KiwiPlastic/Mjolnir/README.md

# Mjolnir - High Performance Nerf Blaster
**Arduino Nano, ESC bushless motors, OLED, Select Fire**

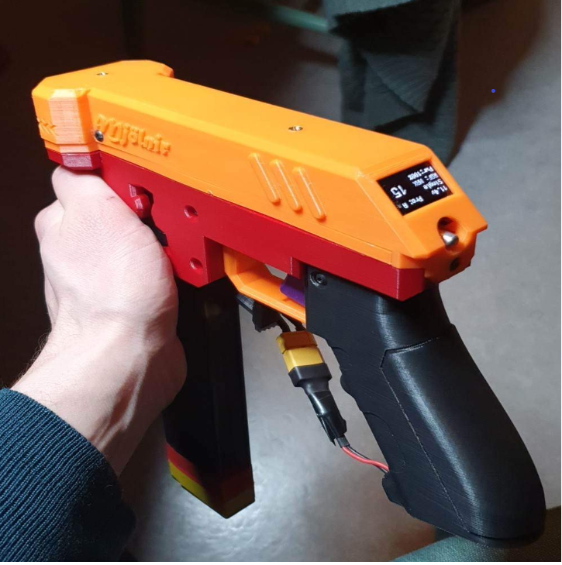
[picture p1: Images/IMG_8636.png]


Hi there and welcome! Thanks alot for checking out Mjölnir - We've been so excited to share this with you, that we simply could'nt wait any longer. This blaster is for the community, by the community. 

This is the finished blaster after about 8 months of work from alot of cool people, but we are hobby-nerf folk, not professionals (Try it out at your own risk).

This is a personal blaster for you and we want you to mod it. There is however a few legal things; The code is a mix of Airzone's free code. This means you are not allowed to sell it. The same goes for the design, which is mainly because we dont want to get kicked off github later on.. 😛 

But you are free to use it as you please to mod etc. You can print all the blasters you want for friends and family for the cost of filament and hugs.

if you have any questions, feel free to reach out to us via discord (https://discord.gg/Edy7qAxdAY) or facebook. 

Kind regards,

Ben, Thor and the rest of the C.R.A.P team

(Cross Rough Atlantic Projects)

## 🚀 Summary

Mjolnir is a Brushless, Solenoid pusher, Micro controlled Blaster with Oled display and Rotary
encoder.

It can be regarded as a medium to advanced electronics project depending on how you approach the
build, however there are no reasons beginners cannot start here -this document is to also help
beginners get involved.

Please see here for detailed Assembly Instructions

Discord Invite

## 🧲 Basic Hardware
    1 x Arduino Nano
    1 x OLED Display
    2 x ESC
    2 x Brushless Motors
    1 x Buck Regulator
    2 x Micro Switch
    1 x Rotary Encoder
    1 x Mosfet
    1 x Solenoid

  **Digram**
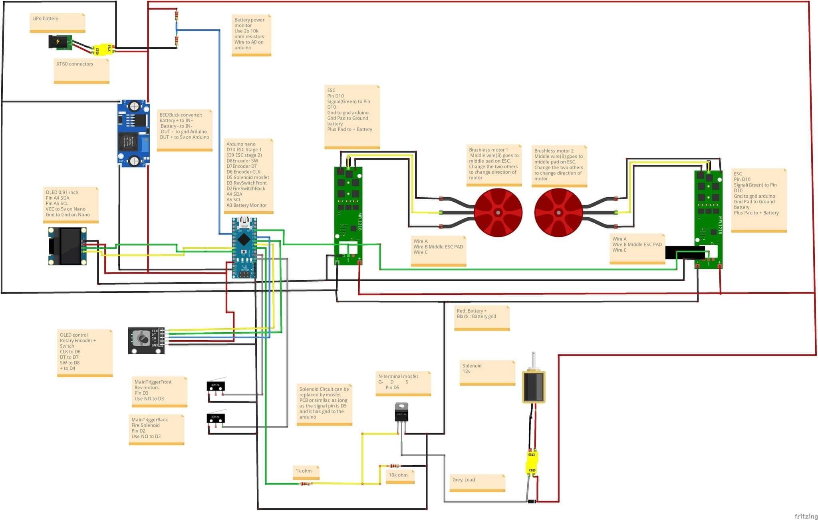
[picture p2: Images/IMG_8562.JPG]


## 🛠️ Usage

Play - Nerf games 
Has 3 firing Modes
 - Singal
 - Burst
 - Auto

Use Encoder and Oled to change setings via menu

## 📜 License
Distributed under the Creative Commons Zero v1.0 Universal License. See `LICENSE` for more information.
