KiwiPlastic/Mjolnir/Images/IMG_8597.PNG

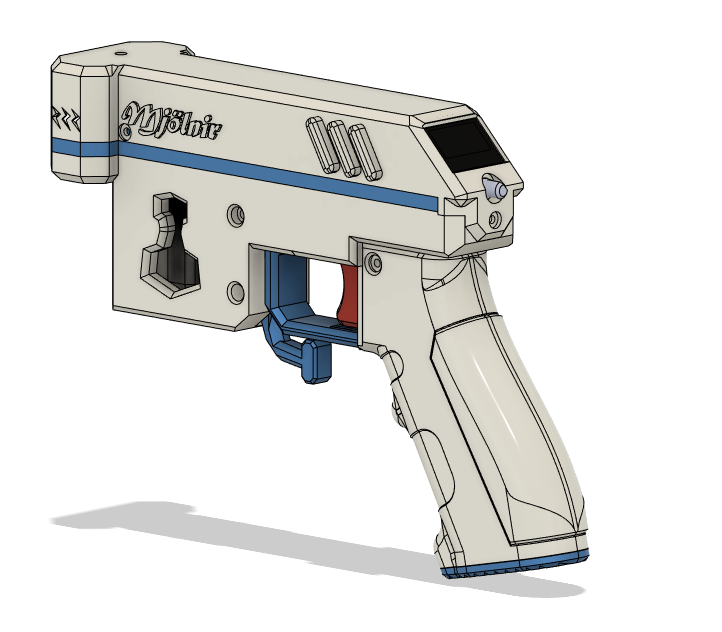
Images/IMG_8597.PNG
