KiwiPlastic/Mjolnir/Images/IMG_8598.PNG

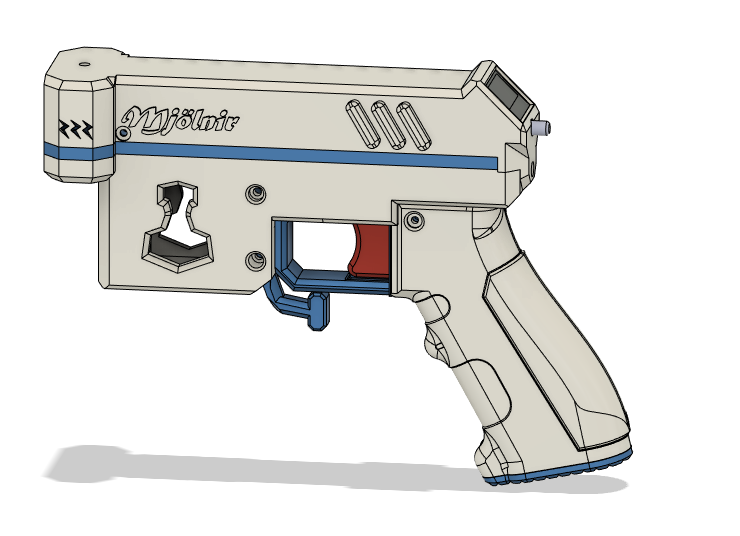
Images/IMG_8598.PNG
