KiwiPlastic/Mjolnir/Images/IMG_8599.PNG

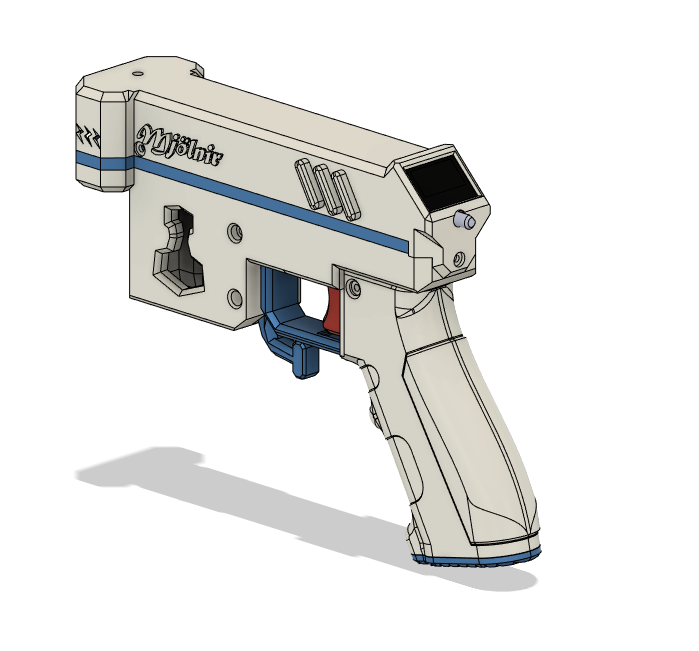
Images/IMG_8599.PNG
