KiwiPlastic/Mjolnir/Images/IMG_8601.PNG

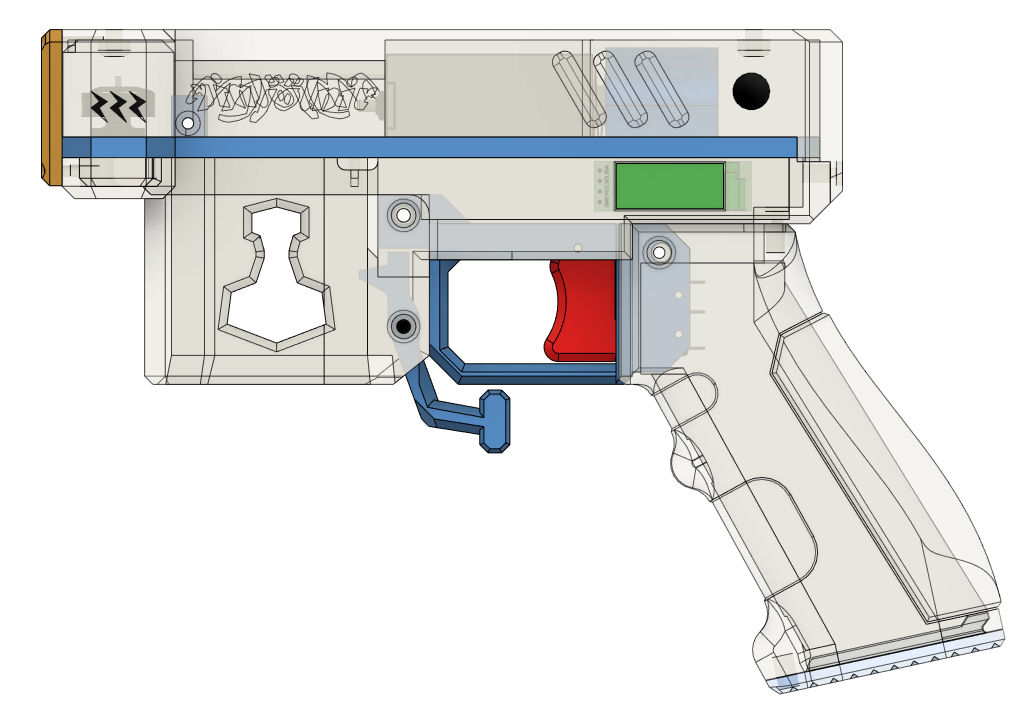
Images/IMG_8601.PNG
