KiwiPlastic/Mjolnir/Images/IMG_8637.JPG

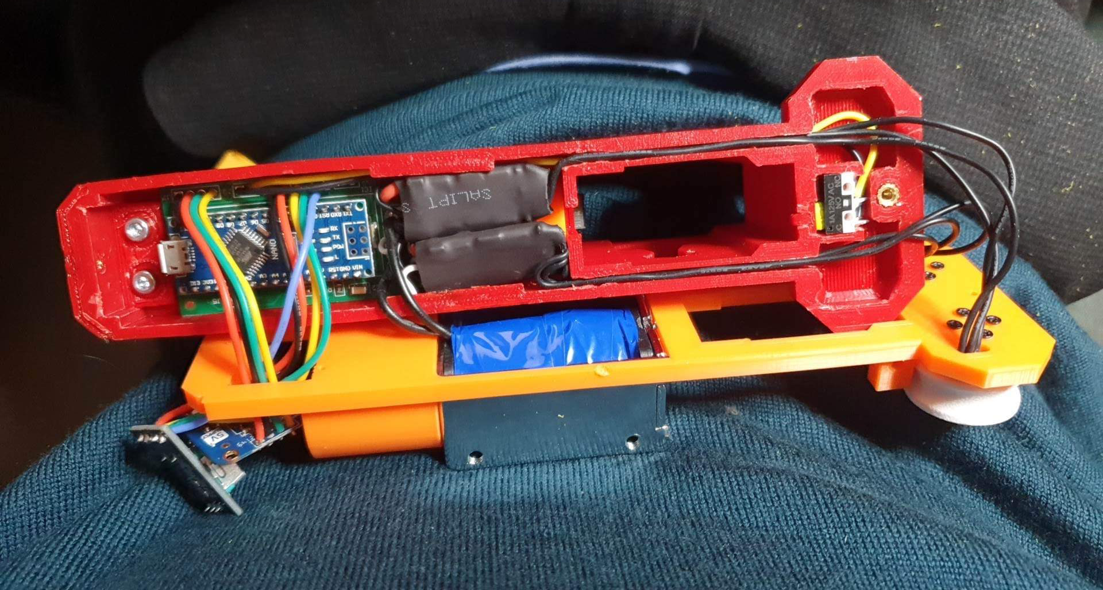
Images/IMG_8637.JPG
