KiwiPlastic/Mjolnir/Images/IMG_8638.JPG

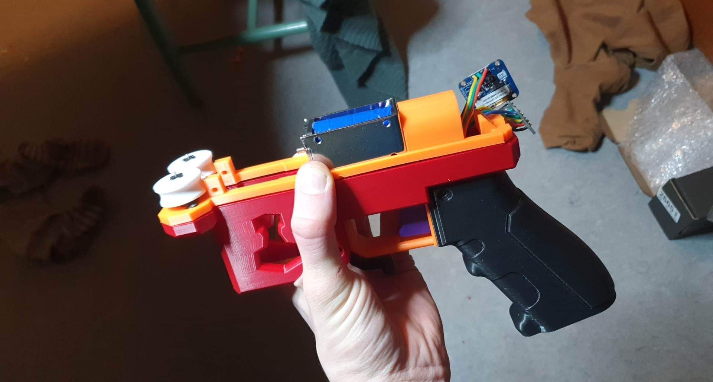
Images/IMG_8638.JPG
