KiwiPlastic/Mjolnir/Images/IMG_8694.JPG

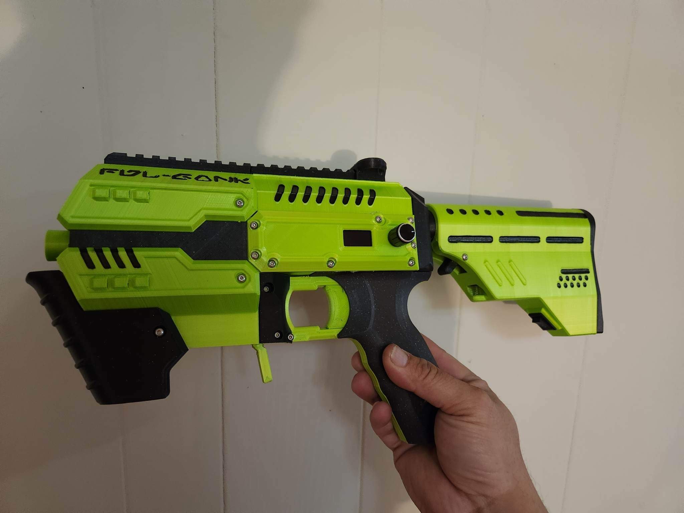
Images/IMG_8694.JPG
