KiwiPlastic/Mjolnir/Images/IMG_8807.JPG

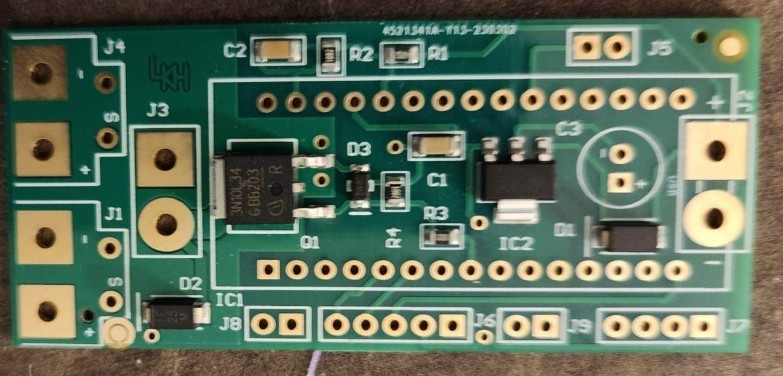
Images/IMG_8807.JPG
