KiwiPlastic/Mjolnir/Images/IMG_E9012.JPG

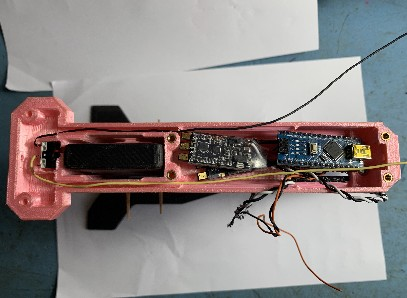
Images/IMG_E9012.JPG
