KiwiPlastic/Mjolnir/Images/WVAA0670.PNG

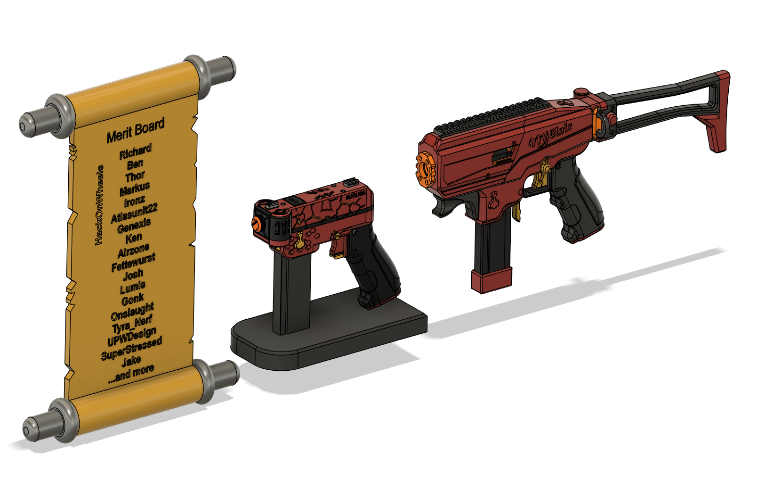
Images/WVAA0670.PNG
