KiwiPlastic/Mjolnir/BOM/Mjolnir_BOM.ods

Sheet: Mjolnir
Mjölnir Base Components
Project files on Github | https://github.com/Bsanford0916/Cross-Rough-Atlantic-Projects
Item | Quantity | Link | Notes
Hardware
M3 screw 6mm (Button Head) | 8 | https://a.co/d/f6d6F2C
M3 screw 8mm (Button Head) | 2 | See options for sizes in above link.
M3 screw 10mm (Button Head) | 7 | See options for sizes in above link.
M2 screw 16mm (Button Head) | 4 | https://a.co/d/7gcIDZh
M2 screw 18mm (Button Head) | 1 | See options for sizes in above link.
Heat Insert (M3x3mm Lengthx5mm OD) | 17 | Https://a.co/d/2s1DLBN
Ballpen spring (mag release) | 1
5mmx2mm Magnet (Battery Lid) | 2
Electronics
Iflight Xing2 1404 4600kV | 2 | Https://a.co/d/bhoQbUt
Blheli_32 35A ESC (20A will work) | 1
Arduino Nano (Atmega328) | 1
Solenoid OOD Neutron | 1 | https://outofdarts.com/products/high-rate-of-fire-compact-solenoid
Rotary Encoder (with push switch) | 1 |  | KY-040 Without board, also in PCB BOM
0.96in OLED I2C (SSD 1306) | 1 | https://a.co/d/a85g2Zs
MicroSwitch 10A | 1 | https://outofdarts.com/products/10a-microswitch-cherry-db2-with-lever | Also in PCB BOM
MicroSwitch 1A | 1 | https://outofdarts.com/products/micro-switch-1a-for-mosfet-builds
Lipo 3s | 1 |  | 650mAh 75c 3s confirmed
22AWG wire | N/A
28AWG Wire | N/A
XT30 set | 1

Sheet: Mjolnir XL
Mjölnir XL Base Components
Project files on Github | https://github.com/Bsanford0916/Cross-Rough-Atlantic-Projects
Item | Quantity | Link | Notes
Hardware
Electronics

Sheet: Mjolnir Carbine
Mjölnir Carbine Base Components
Project files on Github | https://github.com/Bsanford0916/Cross-Rough-Atlantic-Projects
Item | Quantity | Link | Notes
Hardware
Electronics

Sheet: PCB Electronics
Mjölnir PCB Electronics Components
Project files on Github | https://github.com/Bsanford0916/Cross-Rough-Atlantic-Projects
Item | Quantity | Link | Notes
PCB
Capacitor 25v, 47uF | 1 | https://www.mouser.com/ProjectManager/ProjectDetail.aspx?AccessID=42ba671b8e | All in one Order BOM
Ceramic Capacitor 16v, 10uF | 2 |  | MLCC X7R 1206
Zener Diode 5v1 (BZT52C5V1) | 1 |  | SOD-123
Diode (VS-10MQ040-M3/5AT) | 2 |  | Do-214AC (SMA)
Voltage Regulator (UA7805M05CDCY) | 1 |  | SOT223-S
P-channel Mosfet (IPD30N10S3L34ATMA1) | 1 |  | Dpak (TO-252)
47k 1% 0.125W Resistor | 1 |  | R0805
10k 1% 0.125W Resistor | 2 |  | R0805
1k 1% 0.125W Resistor | 1 |  | R0805
2pin Header, 100mil | 2
4pin Header, 100mil | 1
5pin Header, 100mil | 1

Sheet: Alternate Parts
Mjölnir Alternate Components
Project files on Github | https://github.com/Bsanford0916/Cross-Rough-Atlantic-Projects
Item | Quantity | Link | Notes
Micro Dual BEC Board, 7-21V to 5V/12V ADJ | 1 | Https://a.co/d/8TOD3Te | Alternate Component
Isolated Mosfet Relay Board 30V 161A | 1 | Https://a.co/d/1EoDc6Q | LR7843
Solenoid 12V 2.5A (FJ-Z05 or OOD Neutron) | 1 | FJ-Z05 Solenoid Link https://a.co/d/eShqyR8 | Link says JF-Z05, but is the FJ-Z05 solenoid
