KiwiPlastic/Mjolnir/Files for 3d printing/Additional tacticool stuff/Assesories_V.2.4.6.step

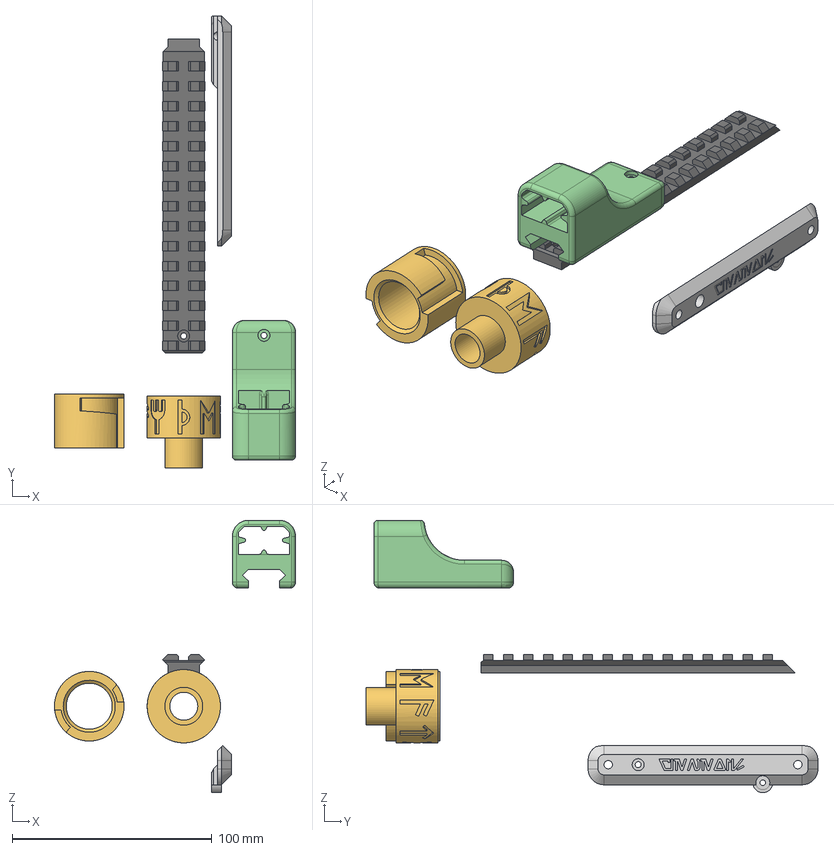
[picture p13: CAD file, 2026-07-24]
Files for 3d printing/Additional tacticool stuff/Assesories_V.2.4.6.step
120.8 x 226.5 x 136.5 mm
Fidlock Mount
Muzzle Threaded T238 Tracer - Works
Assesories_1
Muzzle N-Strike Adapter Not Tested
