KiwiPlastic/Mjolnir/Files for 3d printing/Additional tacticool stuff/Not tested yet/Muzzle-PCAR.stl

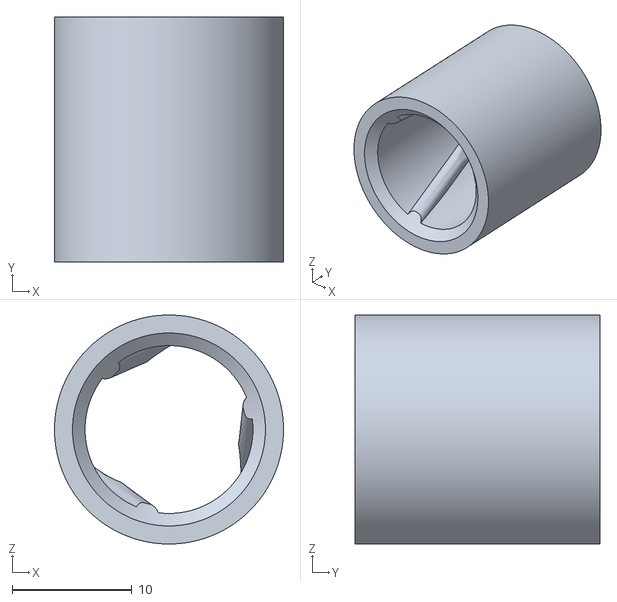
[picture p15: CAD file, 2026-07-24]
Files for 3d printing/Additional tacticool stuff/Not tested yet/Muzzle-PCAR.stl
19.1 x 20.5 x 19.1
