KiwiPlastic/Mjolnir/Files for 3d printing/Additional tacticool stuff/Not tested yet/Muzzle-Outer.stl

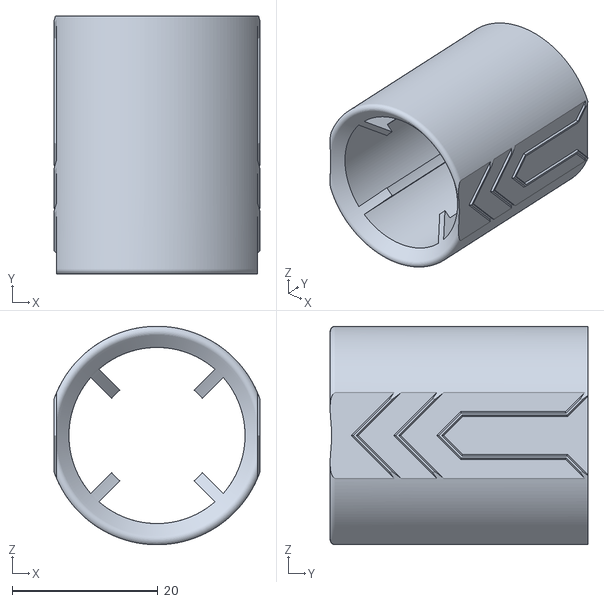
[picture p16: CAD file, 2026-07-24]
Files for 3d printing/Additional tacticool stuff/Not tested yet/Muzzle-Outer.stl
28.3 x 35.4 x 30.0
