KiwiPlastic/Mjolnir/(list of files, cad)

Other CAD files:
Files for 3d printing/Additional tacticool stuff/Not tested yet/PCAR_Muzzle-seperated.stl
